DanCasterIt/dspic-phaser-effect/README.md

# dspic-phaser-effect (not working yet, under developement)

Phaser effect based on the Microchip's dsPIC33FJ128GP802 Digital Signal Controller

## Project block diagram:
project block diagram

## How to compile and run

1) Clone this project
2) Rename this project's folder from "dspic-phaser-effect" to "dspic-phaser-effect.X"
3) Open it with MPLAB X
4) If it does not compile already, right-click on the project name -> properties -> Conf:[default] -> XC16-> xc16-ld -> in "Additional options:" put the string: "--library "dsp""

## Why does it not work?

The phase shifter block requires a VERY FAST atan2() function implementation that works using the Q1.15 fixed point format.
Unfortunately all the implementations I found around the web of this function aren't fast enouth:
The time used to compute atan2() is longer than 1/(36.423529KHz)s that is the period between a sample and the next one.

### Project board:
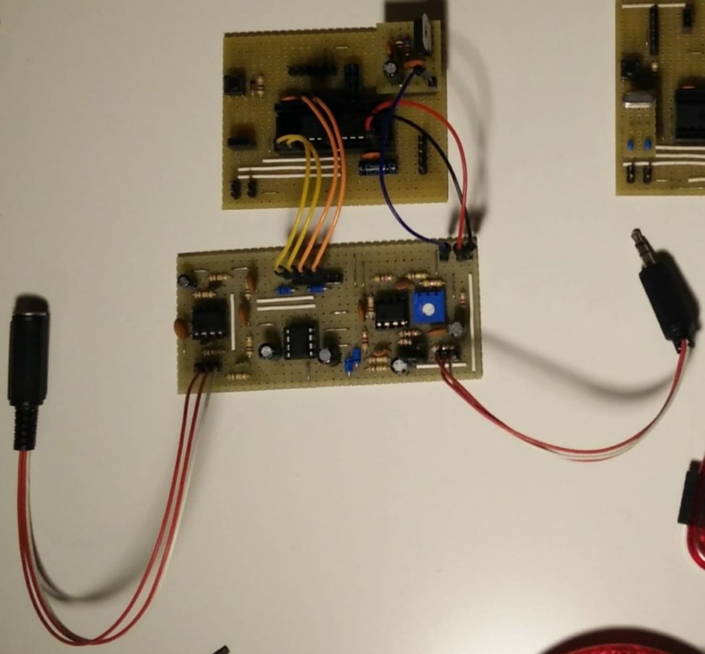
[picture p1: board_files/matrix_breadboard/board.jpg]
project board

### Digital board front:
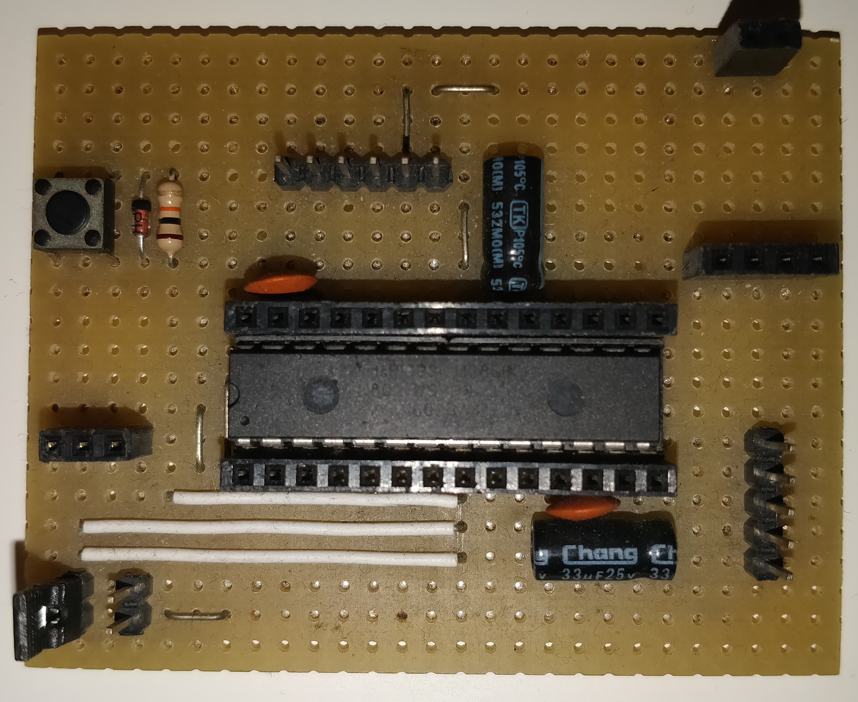
[picture p2: board_files/matrix_breadboard/dsPIC33FJ128GP802_board.jpg]
Digital board front

### Digital board back:
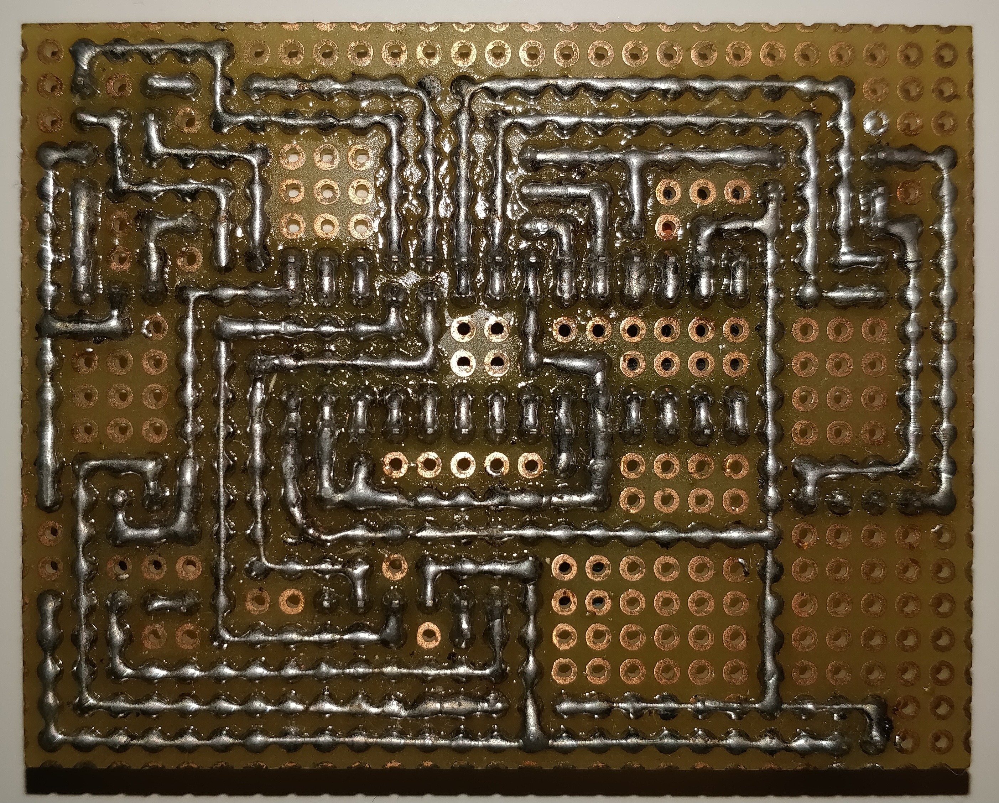
[picture p3: board_files/matrix_breadboard/dsPIC33FJ128GP802_board_wirings.jpg]
Digital board back

### Digital board design:
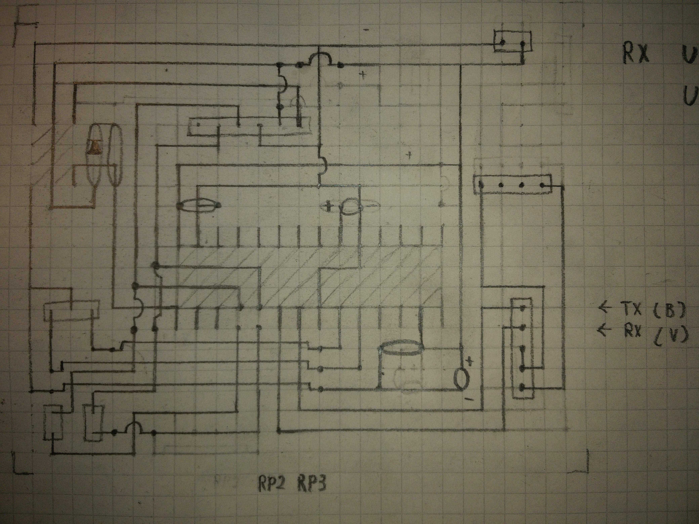
[picture p4: board_files/matrix_breadboard/dsPIC33FJ128GP802_board_design.jpg]
Digital board design

### Analog board front:
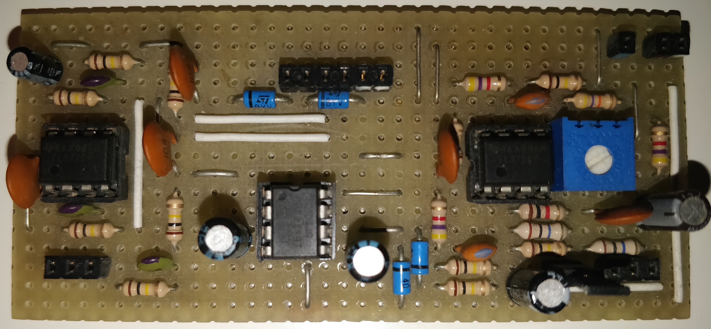
[picture p5: board_files/matrix_breadboard/analog_board.jpg]
Analog board front

### Analog board back:
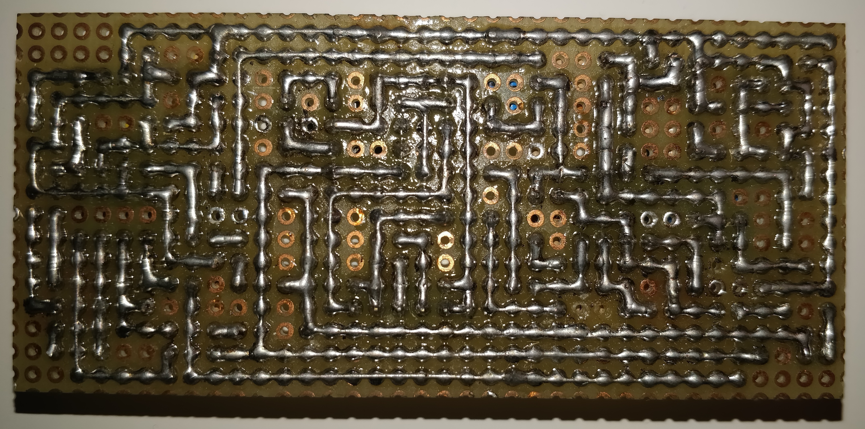
[picture p6: board_files/matrix_breadboard/analog_board_wirings.jpg]
Analog board back

### Analog board design:
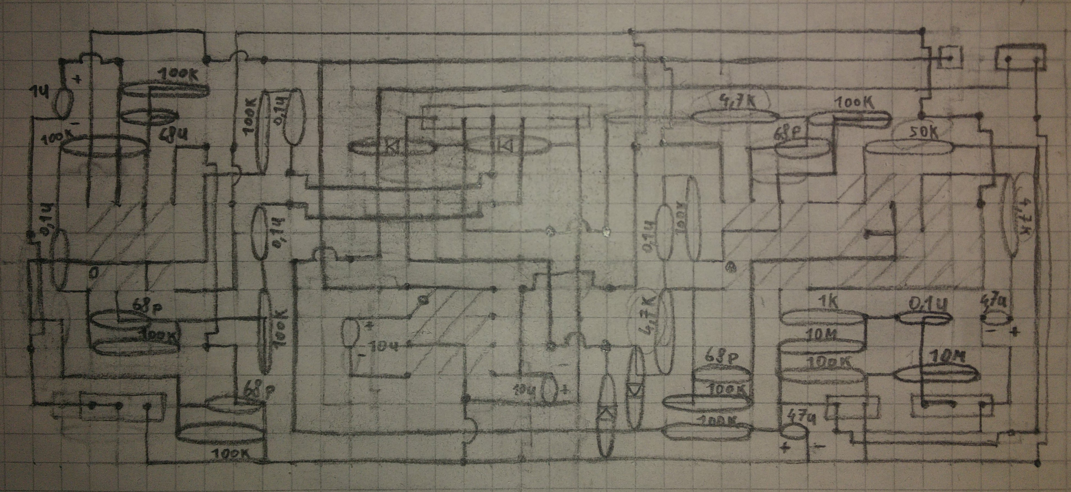
[picture p7: board_files/matrix_breadboard/analog_board_design.jpg]
Analog board design

### Digital board power regulator front:
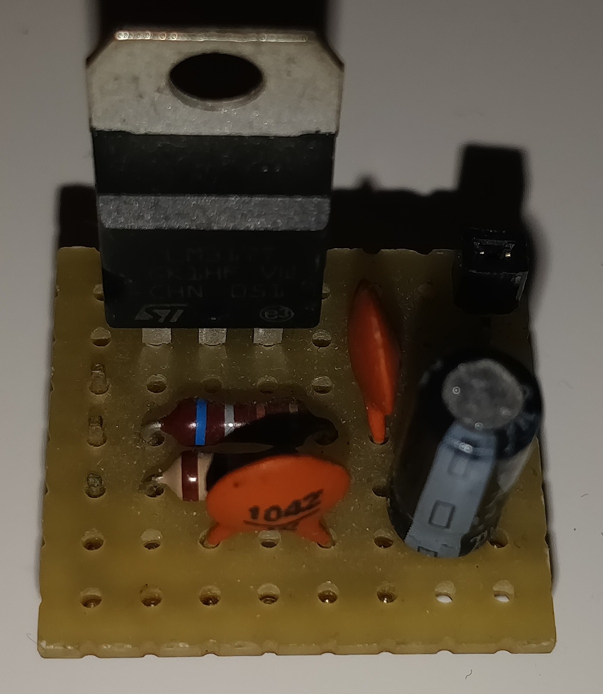
[picture p8: board_files/matrix_breadboard/3v3_board_power_supply.jpg]
Digital board power regulator front

### Digital board power regulator back:
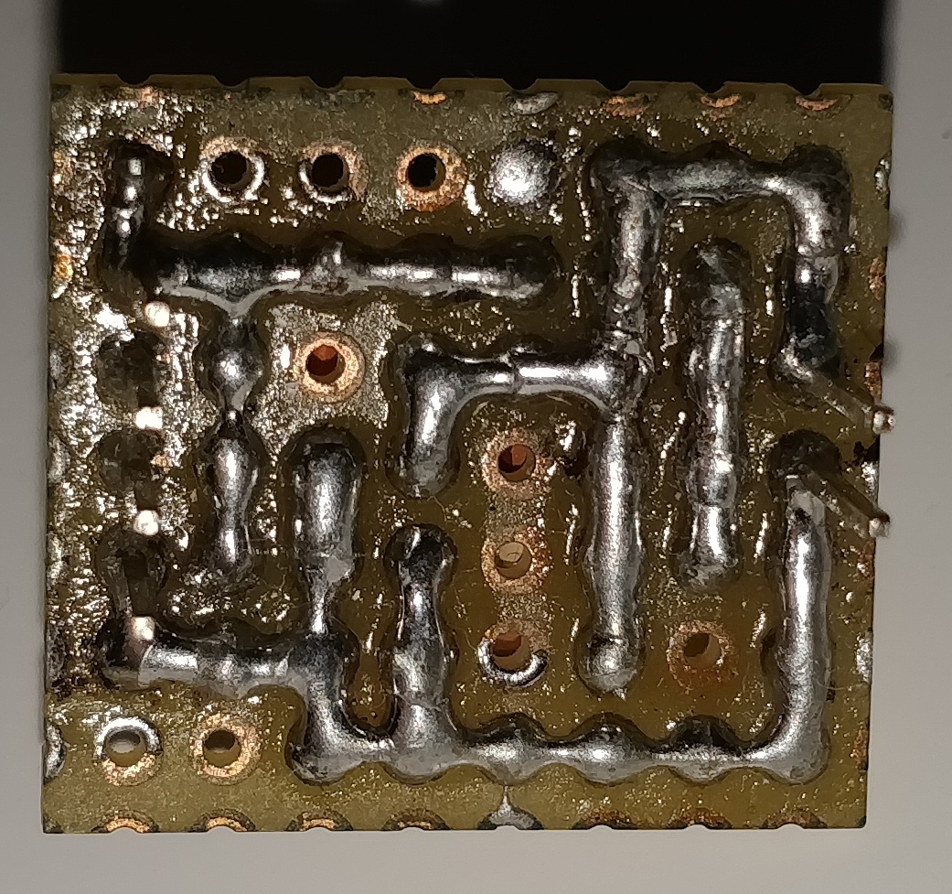
[picture p9: board_files/matrix_breadboard/3v3_board_power_supply_wirings.jpg]
Digital board power regulator back

### Analog circuitry for the ADC:
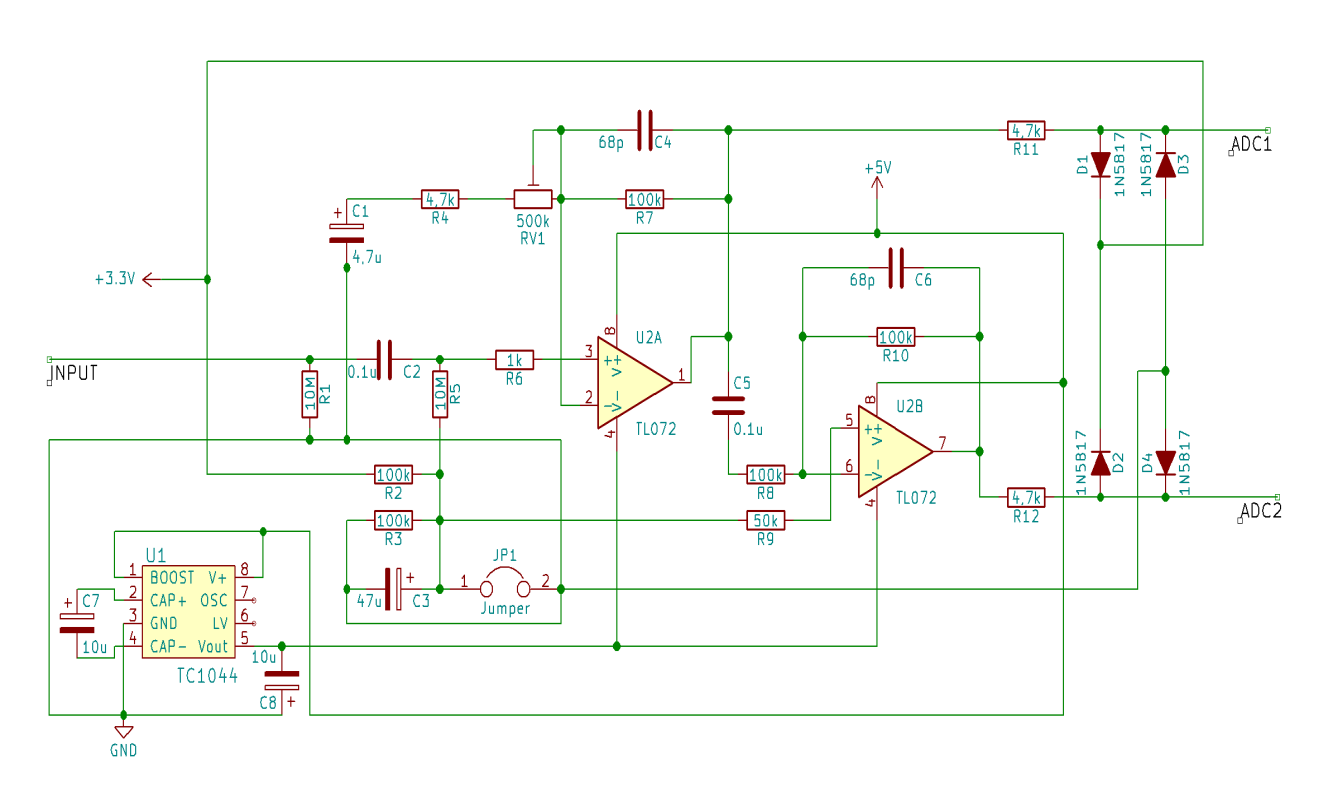
[picture p10: board_files/schematics/analog_circuitry_for_ADC.png]
analog circuitry for the ADC

### Analog circuitry for the DAC:
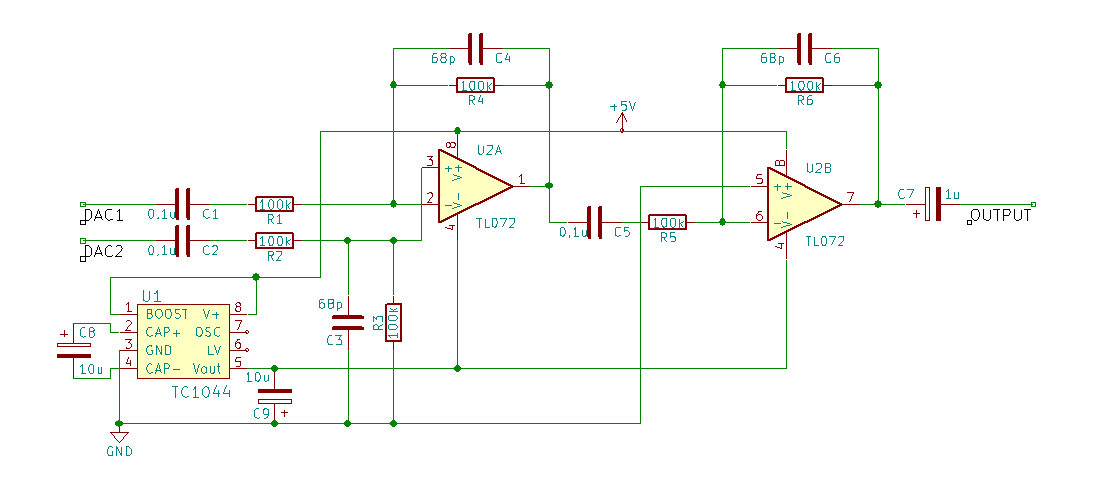
[picture p11: board_files/schematics/analog_circuitry_for_DAC.png]
analog circuitry for the DAC
