DanCasterIt/dspic-phaser-effect/board_files/kicad/analog_pcb.sch

## KiCad design board_files/kicad/analog_pcb.sch (2020-07-24)

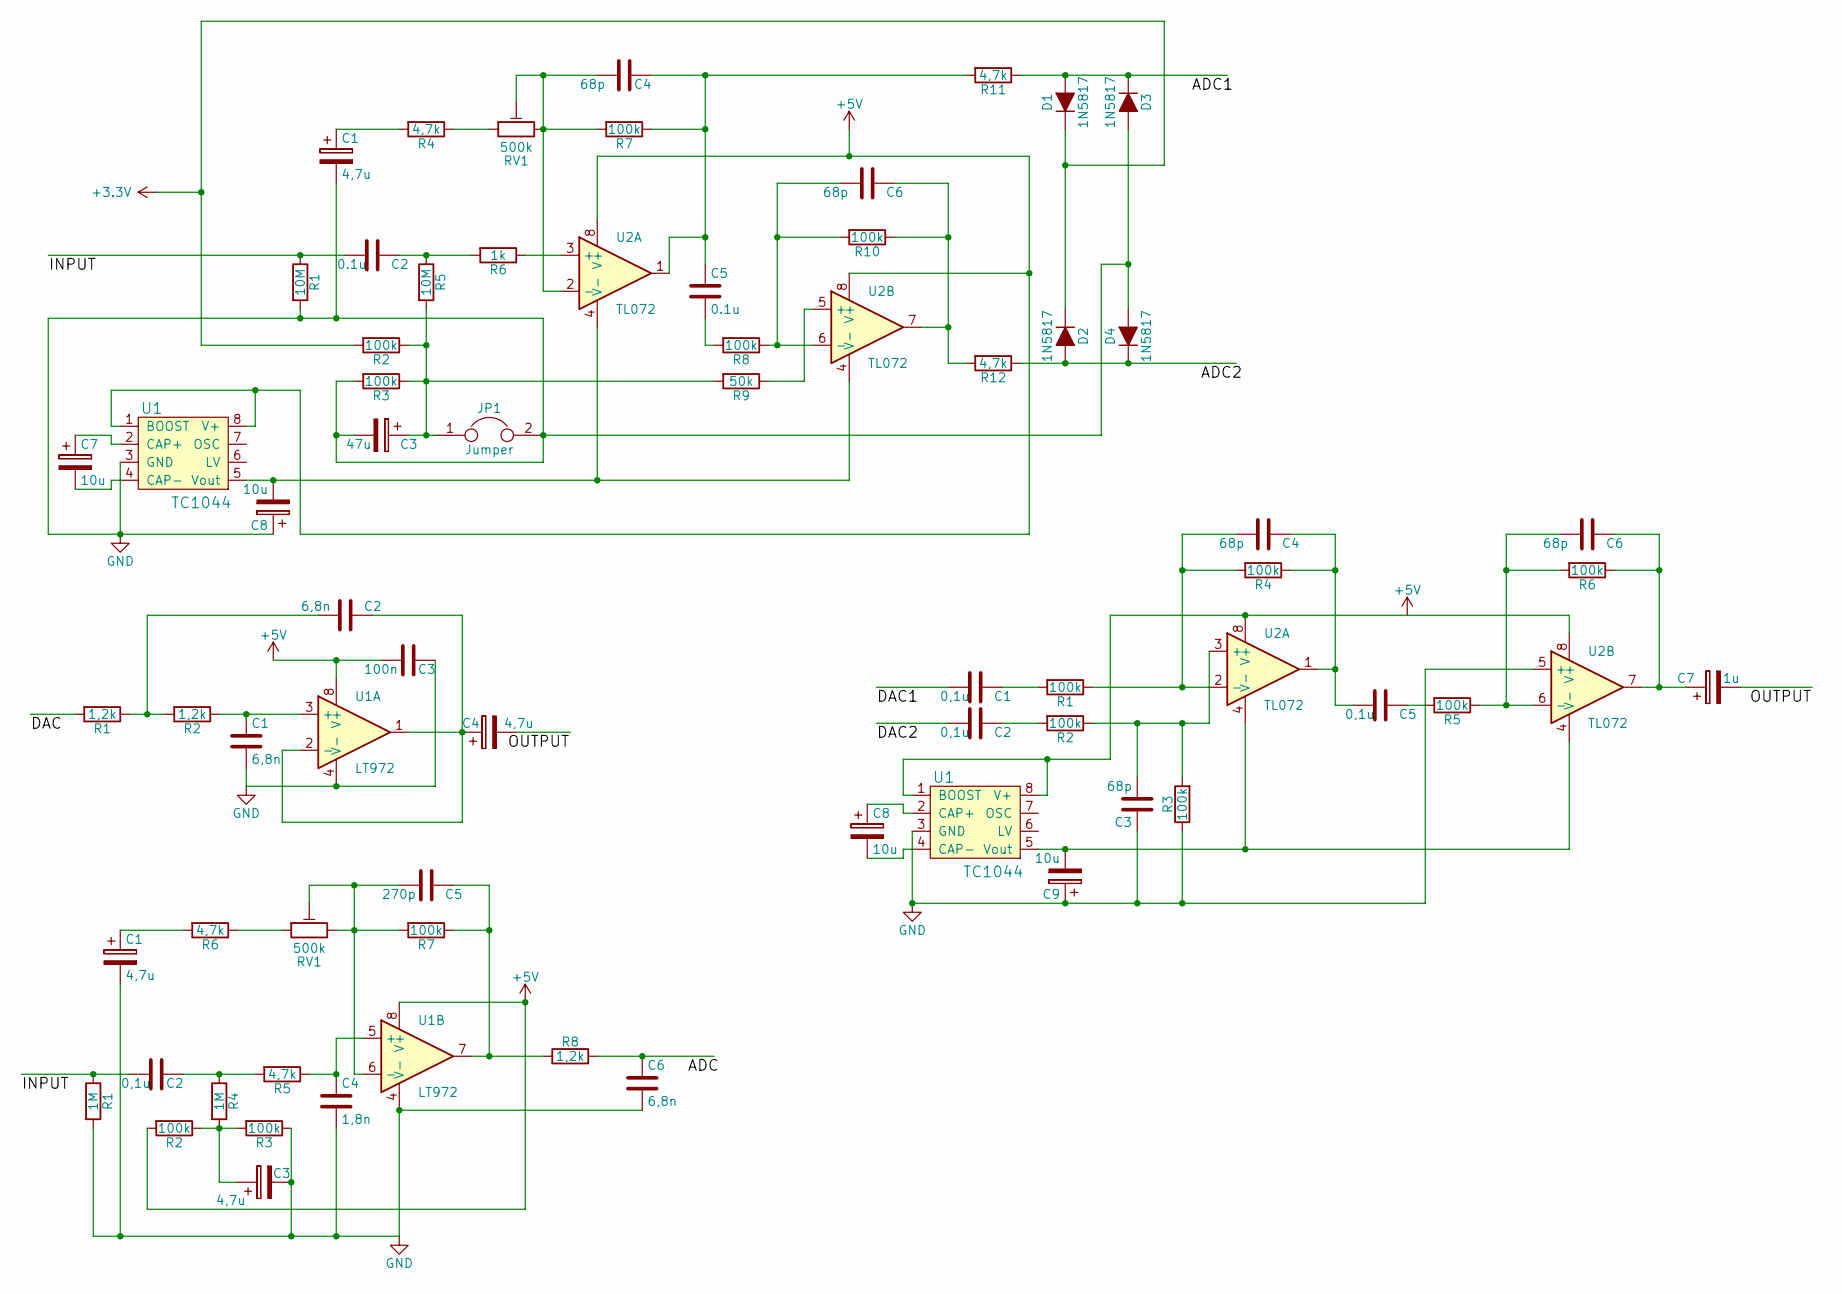
[picture p12: schematic analog_pcb.sch]

Parts:
C1, C3: 4,7u
C2: 0,1u
C4: 1,8n
C5: 270p
C6: 6,8n
C7, C8, C9: 10u
D1, D2, D3, D4: 1N5817
JP1: Jumper
R1, R4: 1M
R2, R3, R7, R10: 100k
R5, R6, R11, R12: 4,7k
R8: 1,2k
R9: 50k
RV1: 500k
U1: LT972
U2: TL072

Connections:
+3.3V: D1.1 (K), D2.1 (K), R2.2
+5V: C3.2, R2.2, U1.1 (BOOST), U1.8 (V+), U2.8 (V+)
GND: C1.2, C3.1, C3.2, C4.2, C6.2, C8.1, C9.1, D3.2 (A), D4.2 (A), JP1.2, R1.2, R3.1, R3.2, U1.3 (GND), U1.4 (CAP-), U2.5 (+)
unnamed: C1.1, R1.2, R2.1, R4.2, R6.2, U1.3 (GND)
unnamed: C2.1, C4.1, R2.2, R4.1, R5.1, R5.2, R6.2, U1.1 (BOOST), U1.2 (CAP+)
unnamed: C2.2, R1.1, R2.2
unnamed: C3.1, JP1.1, R2.1, R3.1, R3.2, R4.2, R5.2, R9.2
unnamed: C3.2, R2.1, R3.2, U2.3 (+)
unnamed: C4.1, C5.1, C5.2, R4.1, R5.1, R7.1, R11.2, U1.5 (Vout), U2.1
unnamed: C4.2, R1.1, R4.2, R7.2, RV1.2, RV1.3, U2.2 (-)
unnamed: C5.1, R5.2, R7.1, R8.1, U1.7 (OSC)
unnamed: C5.2, R7.2, R8.2, RV1.2, RV1.3, U1.6 (LV)
unnamed: C6.1, C7.1, R6.1, R8.2, R10.1, R12.2, U2.7
unnamed: C6.2, R5.1, R6.2, R8.1, R10.2, U2.6 (-)
unnamed: C7.1, U1.2 (CAP+)
unnamed: C7.2, U1.4 (CAP-)
unnamed: C8.1, U1.2 (CAP+)
unnamed: C8.2, U1.4 (CAP-), U1.5 (Vout), U2.4 (V-)
unnamed: C9.2, U1.5 (Vout), U2.4 (V-)
unnamed: D1.2 (A), D3.1 (K), R11.1
unnamed: D2.2 (A), D4.1 (K), R12.1
unnamed: R4.1, RV1.1
unnamed: R6.1, RV1.1, U2.3 (+)
unnamed: R9.1, U2.5 (+)
