DanCasterIt/dspic-phaser-effect/twiddleFactors.c

#include <dsp.h>
#include "main.h"

#if !FFTTWIDCOEFFS_IN_PROGMEM

#if (DMA_BUFFER_LENGHT == 64)
        const fractcomplex twiddleFactors_FFT[] __attribute__ ((space(auto_psv), aligned (DMA_BUFFER_LENGHT*2)))=
        {
        {0x7FFF, 0x0000}, {0x7F62, 0xF374}, {0x7D8A, 0xE707}, {0x7A7D, 0xDAD8},
        {0x7642, 0xCF04}, {0x70E3, 0xC3A9}, {0x6A6E, 0xB8E3}, {0x62F2, 0xAECC},
        {0x5A82, 0xA57E}, {0x5134, 0x9D0E}, {0x471D, 0x9592}, {0x3C57, 0x8F1D},
        {0x30FC, 0x89BE}, {0x2528, 0x8583}, {0x18F9, 0x8276}, {0x0C8C, 0x809E},
        {0x0000, 0x8000}, {0xF374, 0x809E}, {0xE707, 0x8276}, {0xDAD8, 0x8583},
        {0xCF04, 0x89BE}, {0xC3A9, 0x8F1D}, {0xB8E3, 0x9592}, {0xAECC, 0x9D0E},
        {0xA57D, 0xA57D}, {0x9D0E, 0xAECC}, {0x9592, 0xB8E3}, {0x8F1D, 0xC3A9},
        {0x89BE, 0xCF04}, {0x8583, 0xDAD8}, {0x8276, 0xE707}, {0x809E, 0xF374}
        } ;
#endif
#if (DMA_BUFFER_LENGHT == 128)
        const fractcomplex twiddleFactors_FFT[] __attribute__ ((space(auto_psv), aligned (DMA_BUFFER_LENGHT*2)))=
        {
        {0x7FFF, 0x0000}, {0x7FD9, 0xF9B8}, {0x7F62, 0xF374}, {0x7E9D, 0xED38},
        {0x7D8A, 0xE707}, {0x7C2A, 0xE0E6}, {0x7A7D, 0xDAD8}, {0x7885, 0xD4E1},
        {0x7642, 0xCF04}, {0x73B6, 0xC946}, {0x70E3, 0xC3A9}, {0x6DCA, 0xBE32},
        {0x6A6E, 0xB8E3}, {0x66D0, 0xB3C0}, {0x62F2, 0xAECC}, {0x5ED7, 0xAA0A},
        {0x5A82, 0xA57E}, {0x55F6, 0xA129}, {0x5134, 0x9D0E}, {0x4C40, 0x9930},
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
        {0xE0E6, 0x7C2A}, {0xDF61, 0x7BC6}, {0xDDDC, 0x7B5D}, {0xDC59, 0x7AEF},
        {0xDAD8, 0x7A7D}, {0xD958, 0x7A06}, {0xD7D9, 0x798A}, {0xD65C, 0x790A},
        {0xD4E1, 0x7885}, {0xD367, 0x77FB}, {0xD1EF, 0x776C}, {0xD079, 0x76D9},
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
        } ;
#endif

#endif
